he1ias/programmable-guitar-pedal/KiCad Files/Guitar Pedal.step

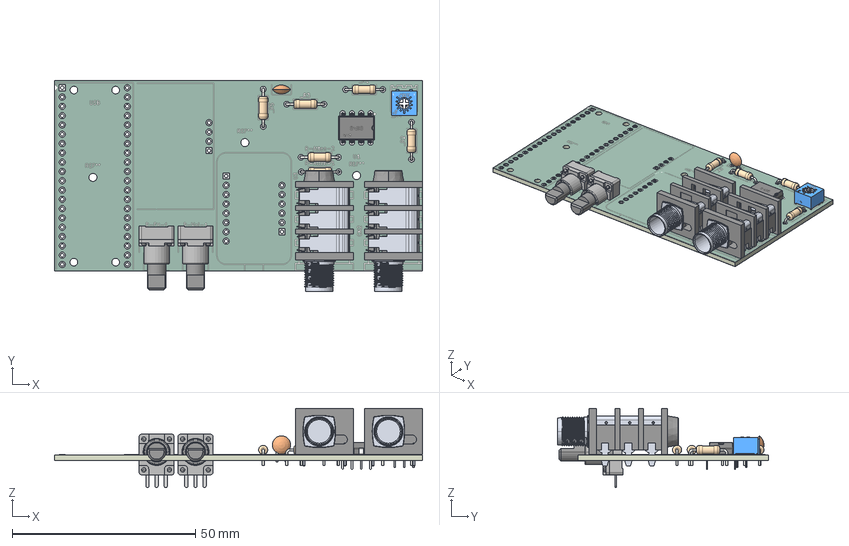
[picture p5: CAD file, 2026-10-22]
KiCad Files/Guitar Pedal.step
100.5 x 57.7 x 21.6 mm
R_Axial_DIN0207_L63mm_D25mm_P1016mm_Horizontal x 6
RES-ADJ-TH_RK09Y11L0001 x 2
RES-ADJ-TH_3362P
DIP-8_L9.8-W6.6-H3.5-LS7.62-P2.54
C_Disc_D50mm_W25mm_P250mm
AUDIO-TH_PJ-611E x 2
Guitar Pedal_copper
Guitar Pedal_pad
Guitar Pedal_via
Guitar Pedal_silkscreen
Guitar Pedal_soldermask x 2
Guitar Pedal_PCB
