he1ias/programmable-guitar-pedal/KiCad Files/Guitar Pedal.kicad_pcb

## KiCad design KiCad Files/Guitar Pedal.kicad_pcb (2026-10-22)

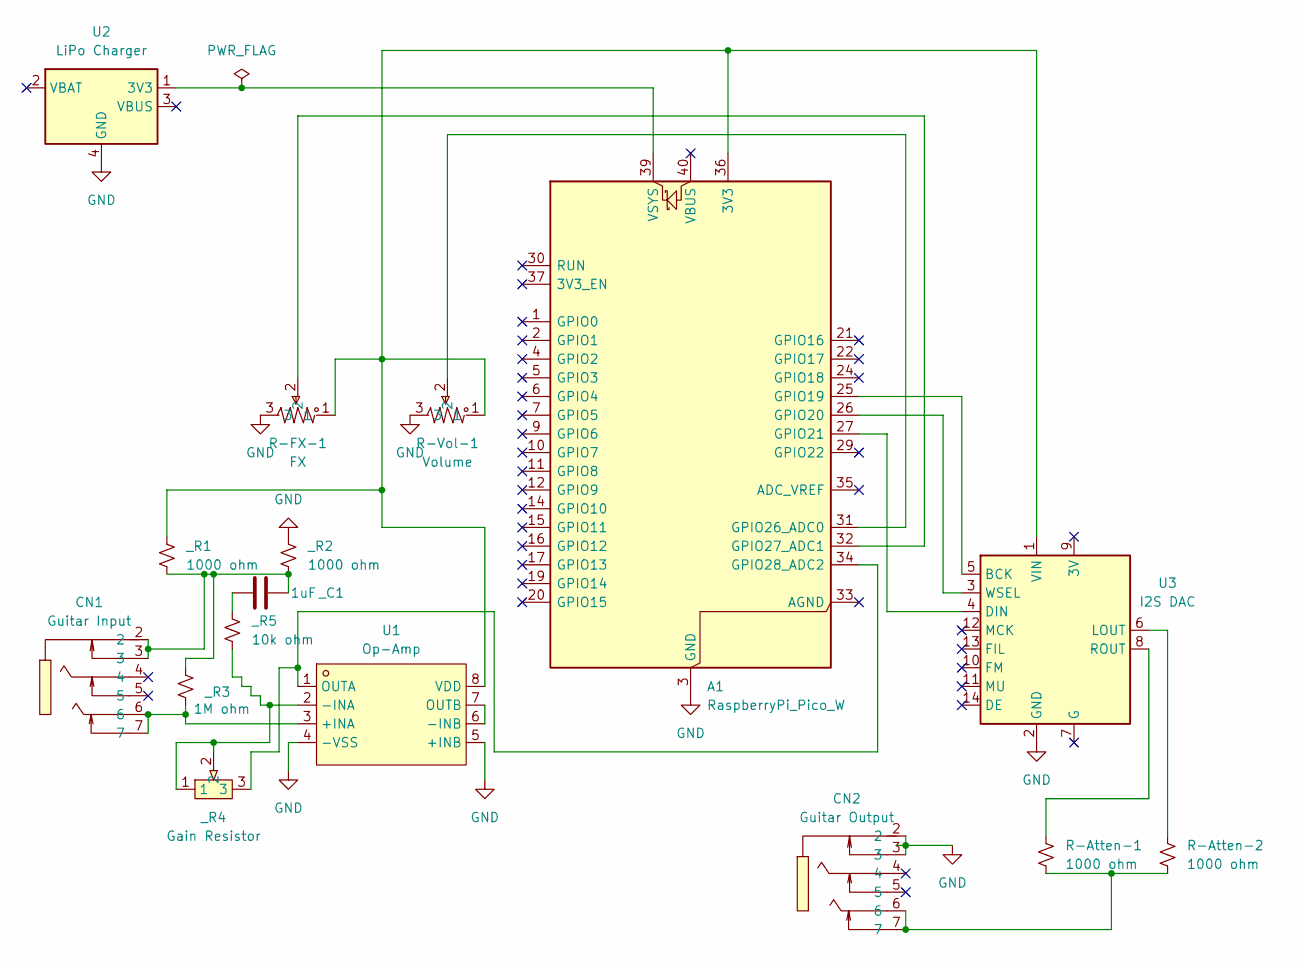
[picture p6: schematic Guitar Pedal.kicad_sch]

Parts:
A1: RaspberryPi_Pico_W; RPi_Pico2_WH_THT
CN1: Guitar Input; AUDIO-TH_PJ-611E; MPN PJ-611E; LCSC Part C41409495
CN2: Guitar Output; AUDIO-TH_PJ-611E; MPN PJ-611E; LCSC Part C41409495
R-Atten-1, R-Atten-2: 1000 ohm; R_Axial_DIN0207_L6.3mm_D2.5mm_P10.16mm_Horizontal
R-FX-1: FX; RES-ADJ-TH_RK09Y11L0001; MPN RK09Y11L0001; LCSC Part C470717
R-Vol-1: Volume; RES-ADJ-TH_RK09Y11L0001; MPN RK09Y11L0001; LCSC Part C470717
U1: Op-Amp; DIP-8_L9.4-W6.4-P2.54-LS9.1-BL; MPN MCP6002T-I/SN; LCSC Part C7377
U2: LiPo Charger; Makerverse_USB-C_LiPo_Charger_CE08374
U3: I2S DAC; Adafruit_PCM5100_I2S_DAC_ADA6251
_C1: 1uF; C_Disc_D5.0mm_W2.5mm_P2.50mm
_R1, _R2: 1000 ohm; R_Axial_DIN0207_L6.3mm_D2.5mm_P10.16mm_Horizontal
_R3: 1M ohm; R_Axial_DIN0207_L6.3mm_D2.5mm_P10.16mm_Horizontal
_R4: Gain Resistor; RES-ADJ-TH_3P-L7.1-W6.9-P2.50-L_3362P; MPN 3362P-1-105; LCSC Part C118945
_R5: 10k ohm; R_Axial_DIN0207_L6.3mm_D2.5mm_P10.16mm_Horizontal

Connections:
GND: A1.3 (GND), A1.8 (GND), A1.13 (GND), A1.18 (GND), A1.23 (GND), A1.28 (GND), A1.38 (GND), CN2.2, CN2.3, R-FX-1.3, R-Vol-1.3, U1.4 (-VSS), U1.5 (+INB), U2.4 (GND), U3.2 (GND), _R2.1
unnamed: A1.36 (3V3), R-FX-1.1, R-Vol-1.1, U1.8 (VDD), U3.1 (VIN), _R1.1
unnamed: A1.25 (GPIO19), U3.5 (BCK)
unnamed: A1.26 (GPIO20), U3.3 (WSEL)
unnamed: A1.27 (GPIO21), U3.4 (DIN)
unnamed: A1.31 (GPIO26_ADC0), R-Vol-1.2
unnamed: A1.32 (GPIO27_ADC1), R-FX-1.2
unnamed: A1.34 (GPIO28_ADC2), U1.1 (OUTA), _R4.3
unnamed: A1.39 (VSYS), U2.1 (3V3)
unnamed: CN1.2, CN1.3, _C1.2, _R1.2, _R2.2, _R3.1
unnamed: CN2.6, CN2.7, R-Atten-1.2, R-Atten-2.2
unnamed: CN1.6, CN1.7, U1.3 (+INA), _R3.2
unnamed: U1.2 (-INA), _R4.1, _R4.2, _R5.2
unnamed: U1.6 (-INB), U1.7 (OUTB)
unnamed: R-Atten-2.1, U3.6 (LOUT)
unnamed: R-Atten-1.1, U3.8 (ROUT)
unnamed: _C1.1, _R5.1

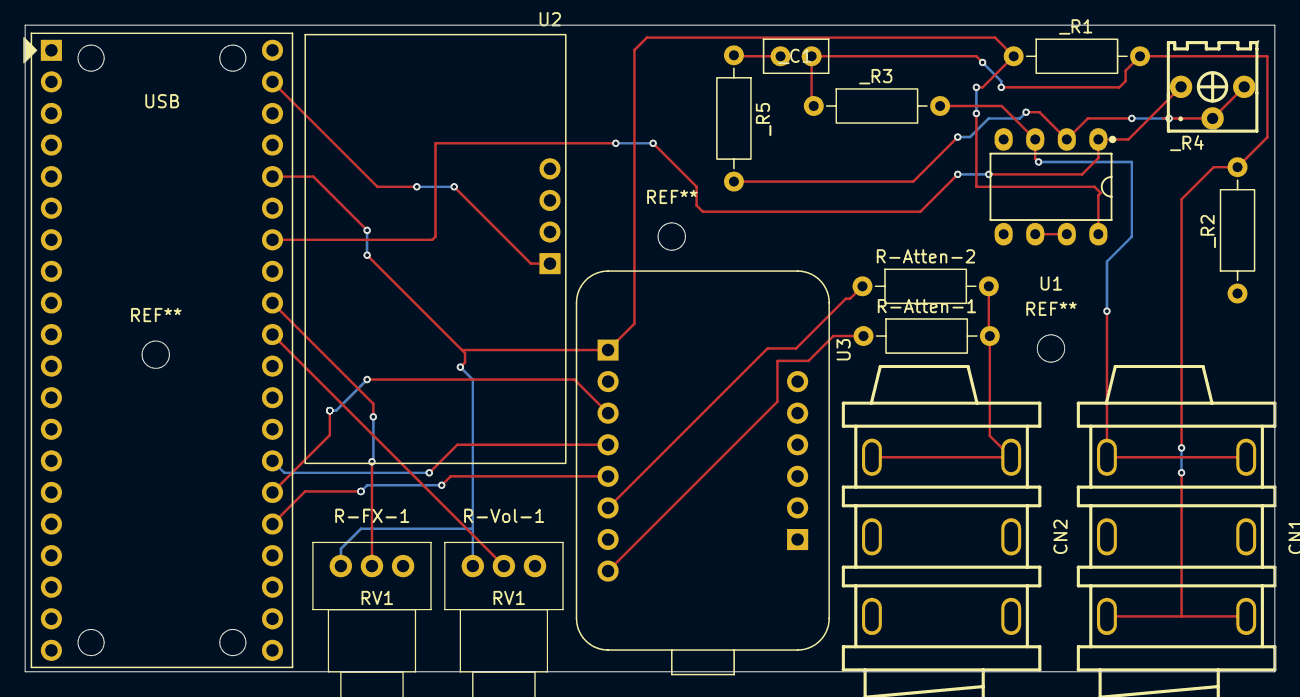
[picture p7: board Guitar Pedal.kicad_pcb from above]

Board: 2 copper layers, 100.5 x 52.0 mm, 16 parts (0 on the bottom side), 17 nets.
