he1ias/programmable-guitar-pedal/JOURNAL.md

# Programmable Guitar Pedal – devlog

<!-- Generated by Half Life from project cmvew0bcu0act01rcn6ro3t11. Edits here are overwritten on the next sync. -->
<!-- Generated: 2026-10-25T05:15:56.578Z -->

> [!NOTE]
> This devlog is mirrored from [Half Life](https://halflife.hackclub.com) – [open the project](https://halflife.hackclub.com/projects/cmvew0bcu0act01rcn6ro3t11). Editing it here will not change the platform's copy, and the next sync overwrites this file.

> A programmable acoustic guitar pedal that doubles as a wireless instrument recording device. Simply plug in your guitar, access the Pi's web interface and start playing around with an infinite number guitar effects!

| Week | Tier | Hours logged | Entries |
| --- | --- | --- | --- |
| Week 3 | Tier 2 | 20h | 6 |

## Contents

1. [2026-10-20 – ## W3: Programmable Guitar Pedal](#2026-10-20-w3-programmable-guitar-pedal)
2. [2026-10-20 – ## W3: Programmable guitar pedal](#2026-10-20-w3-programmable-guitar-pedal)
3. [2026-10-21 – ## W3: Programmable Guitar Pedal](#2026-10-21-w3-programmable-guitar-pedal)
4. [2026-10-21 – ## W3: Programmable Guitar Pedal](#2026-10-21-w3-programmable-guitar-pedal)
5. [2026-10-24 – ## W3: Programmable guitar pedal](#2026-10-24-w3-programmable-guitar-pedal)
6. [2026-10-25 – ## W3: Programmable guitar pedal](#2026-10-25-w3-programmable-guitar-pedal)

## Design

### 2026-10-20 – ## W3: Programmable Guitar Pedal

**5h**

## W3: Programmable Guitar Pedal
### Entry 1: Firmware tools & breadboard amplifiers

I have two options for creating my guitar pedal:

1. Buy a bunch of ICs and wire them together, costing me a lot and making the development of my PCB easy
2. Use passive components (eg. resistors, transistors, and capacitors) to do all the heavy lifting, including amplification and attenuation of the audio signals.

This session was spent exploring option two: this definitely felt like my preference at first, it seemed simpler and would allow me to learn more. This assumption turned out to be a mistake!!!

### Building a wireless voltmeter

I wanted to explore what voltages / currents I would be working with. I did have a voltmeter I could use, but I felt like I needed something a bit more visual - so I set out to create a voltmeter web application that I could run on my Raspberry Pi Pico, and access from my computer.

The code is a python web server:



...that hosts a HTML canvas webpage:



...which looks like the following (in this example I connected my computer's audio jack output to the voltmeter):

IMG_8415 Large

### Building (attemping to build) the signal amplifiers

This is where my efforts to fulfil option 2 fell a bit apart...

I started by creating a single-transistor voltage amplifier with a breadboard, some resistors, and some capacitors:

IMG_8419 Large

While this appeared to help amplify the audio jack output, it only worked when I set my laptop to a high volume. This wasn't good news, as even the quietest line-level (consumer audio) signal is about ~100 times larger than my acoustic guitar output.

And so I had to switch strategies, creating a two:

IMG_8422 Large

...and then 3 transistor breadboard circuit:

IMG_8423 Large

However, as the previous image shows, the extra amplification didn't seem to improve the amplitude of the output audio signal. It was at this point that I realised I kindddd of don't have much of a clue what I'm doing...

This session may have seemed like a waste of time, however it did rule option 2 off the table, which means I'll revert to a setup of buying dedicated audio ICs (eg. pre-amps, ADC / DACs) and simply connect them up in KiCad.

Next session will therefore be deciding which specific functionality, and therefore components, I want in my pedal.

Thanks for reading :)

### 2026-10-20 – ## W3: Programmable guitar pedal

**4h**

## W3: Programmable guitar pedal
### Finalising design, sourcing components

This session was spent finalising the layout and sourcing the components for the guitar pedal, experimenting with my guitar amplifier and creating the bill of materials in my GitHub repository.

I first created the following flow diagram showing the design of the pedal:

IMG_8428 Large

I definitely tried to use as few components as possible, looking to keep the costs down. One example is this test of line level audio with my guitar amplifier. I initially thought direct audio would be too hot for the amplifier, however this test showed that I wouldn't need any attenuation of the DAC output. These little savings help simplify my design, and make sure I don't go over budget.

IMG_8427 Large

The rest of the time was spent sourcing my components. I initially wanted to source all my components from LCSC, as I could ship this with my PCB and 3D-printing orders, saving money. However, this was found to be impractical, and I ended up sourcing components from 3 seperate places.

Some components were especially important to get, such as the Pico 2 WH, which was an in-built FPU perfect for fast digital signal processing, which was definitely needed here:



I ended up with the following:

```
JLC (shipping ~$5) - all in USD {

JLCPCB ~$10
JLC3DP ~$5

LCSC:
  * Guitar inputs (C41409495): 2 * $0.5 = $1    https://www.lcsc.com/product-detail/C41409495.html
  * Potentiometers (C470717): 3 * $0.57 = $1.71 https://www.lcsc.com/product-detail/C470717.html
  * Op-Amp (C5213) 5 * $0.22 = $1.11            https://www.lcsc.com/product-detail/C5213.html
}

Core Electronics (shipping ~$10) - all in AUD:
    * Raspberry Pi Pico WH $14.30 https://core-electronics.com.au/raspberry-pi-pico-2-wh-with-headers.html
    * Battery $5.55               https://core-electronics.com.au/polymer-lithium-ion-battery-400mah-38456.html
    * Charger $6.85               https://core-electronics.com.au/makerverse-usb-c-lipo-charger.html
    * DAC $8.05                   https://core-electronics.com.au/adafruit-pcm5100-i2s-dac-line-level-output-100db-snr.html
    * Headers (2 x $0.35 = $0.70) https://core-electronics.com.au/0-100-2-54-mm-female-header-1x20-pin-straight.html

Jaycar - all in AUD:
    * 6.5mm audio cable $12.25    https://www.jaycar.com.au/6-5mm-mono-plug-to-6-5mm-mono-r-a-plug-audio-cable-3m/p/WA7024

approx cost ~$64 USD = 13 hours of work
```

The BOM turned out like the following, and can now be found in the GitHub repo for this project:



Thanks for reading :)

### 2026-10-21 – ## W3: Programmable Guitar Pedal

**5h**

## W3: Programmable Guitar Pedal
### Building the schematic

This session was spent building the KiCad schematic. I began by sourcing the footprints & components. The first couple were easy enough; I used the `easyeda2kicad` Python library to convert the LCSC components to footprints ready to use in KiCad.

The others couldn't as readily be found online - these ones I had to design myself in KiCad (using experience I had from my W1 Rubber Ducky project).

The USB-C LiPo charger ended up like the following:



...and the DAC audio output footprint looked like this:



After importing all of these, into KiCad, I arrived at the following:

IMG_8429 Large

I then completed the DAC audio output circuit and audio attenuator:

IMG_8433 Large

...and the op-amp circuit (which was wayyy more complicated than I thought it would be):

Journal image

The final wiring ended up like the following:

IMG_8435 Large

All thats left to do is route the PCB, and design the 3D-printed guitar pedal shell!

Thanks for reading :)

### 2026-10-21 – ## W3: Programmable Guitar Pedal

**4h**

## W3: Programmable Guitar Pedal
### Routing the PCB

This session was spent routing the PCB.

I first needed to finalise the components and footprints I would be using for my board. One change I made was using a precision 1M ohm pentiometer rather than one with a knob, as I originally had planned. Once a good gain setting for the guitar has been set, this setting would no longer need to be touched, so I found it straightforward to hide this setting from everyday use, giving me more control and precision.



I then placed the components approximately where I wanted them to end up, keeping all the inputs / outputs on the one side. Note the Pico's Micro USB would not need to be accessed during everyday use and therefore could be hidden away on the opposite side of the board:

IMG_8441 Large

IMG_8444 Large

I then routed my pins, and added a ground fill on the underside:

IMG_8445 Large

I ended up with the following:

IMG_8447 Large

I have to say I'm quite happy with the compact, 10cm by 5cm design, and I feel I've struck a good balance between audio quality, simplicity, and features in my PCB.

After passing ERC and DRC, I exported the Gerbers to my GitHub repository, ready for printing.

All thats left to do now is assemble the 3D-printed enclosure, and program the firmware of the Pico.

Thanks for reading!

### 2026-10-24 – ## W3: Programmable guitar pedal

**1.5h**

## W3: Programmable guitar pedal
### Firmware & FX

This session was spent designing the firmware for the pedal, specifically working out how to implement some basic guitar effect in code.

I started by working with overdrive, distortion, and fuzz: I used Desmos to work out good waveforms for each of these effects, which I then implemented in my Micropython code.





I also created effects for reverb and echo.



After doing some basic Python audio I/O, I used these basic functions to test a few effects using a recording of me playing the guitar.

The full code, as well as example guitar I/O can be found on my [GitHub](https://github.com/he1ias/programmable-guitar-pedal).

All that's left to do is the pedal's case (although I may have run out of time for it at this point, and it isn't strictly required).

Thanks for reading :)

### 2026-10-25 – ## W3: Programmable guitar pedal

**0.5h**

## W3: Programmable guitar pedal
### Finalising & submitting

This short session was spent finalising BOM.csv, my README.md and my GitHub repo, ready to submit.

Note that I ran out of time to implement the pedal casing. I also removed the battery functionality of the pedal, as I wanted to cut costs and I felt that this part of my project was unescessary, and complicated things.

As the charger only connects to the Pi's VSYS, nothing else about my design needed to change. I will keep the PCB the same so I can add this functionality back in in the future.



README.md looks like the following:



That wraps up this weeks project!

Thanks for reading :)
