he1ias/programmable-guitar-pedal/(commit log)

2026-10-21 Sync Programmable Guitar Pedal from Half Life
    [BOM.csv]
2026-10-21 KiCad Files
    [Guitar Pedal-B_Cu.gbr, Guitar Pedal-B_Mask.gbr, Guitar Pedal-B_Paste.gbr, Guitar Pedal-B_Silkscreen.gbr, Guitar Pedal-Edge_Cuts.gbr, Guitar Pedal-F_Cu.gbr, Guitar Pedal-F_Mask.gbr, Guitar Pedal-F_Paste.gbr]
2026-10-22 Drill holes, 3D KiCad outputs
    [Guitar Pedal-B_Cu.gbr, Guitar Pedal-B_Mask.gbr, Guitar Pedal-B_Paste.gbr, Guitar Pedal-B_Silkscreen.gbr, Guitar Pedal-Edge_Cuts.gbr, Guitar Pedal-F_Cu.gbr, Guitar Pedal-F_Mask.gbr, Guitar Pedal-F_Paste.gbr]
2026-10-25 update bom.csv, readme
    [bom.csv]
